Pyrykoi/Keyboard-project/README.md

Mechanical keyboard project including PCB and QMK files.
More information can be found in pdf.
