Pyrykoi/Keyboard-project/PCB v2/Pictures/explosion1.png

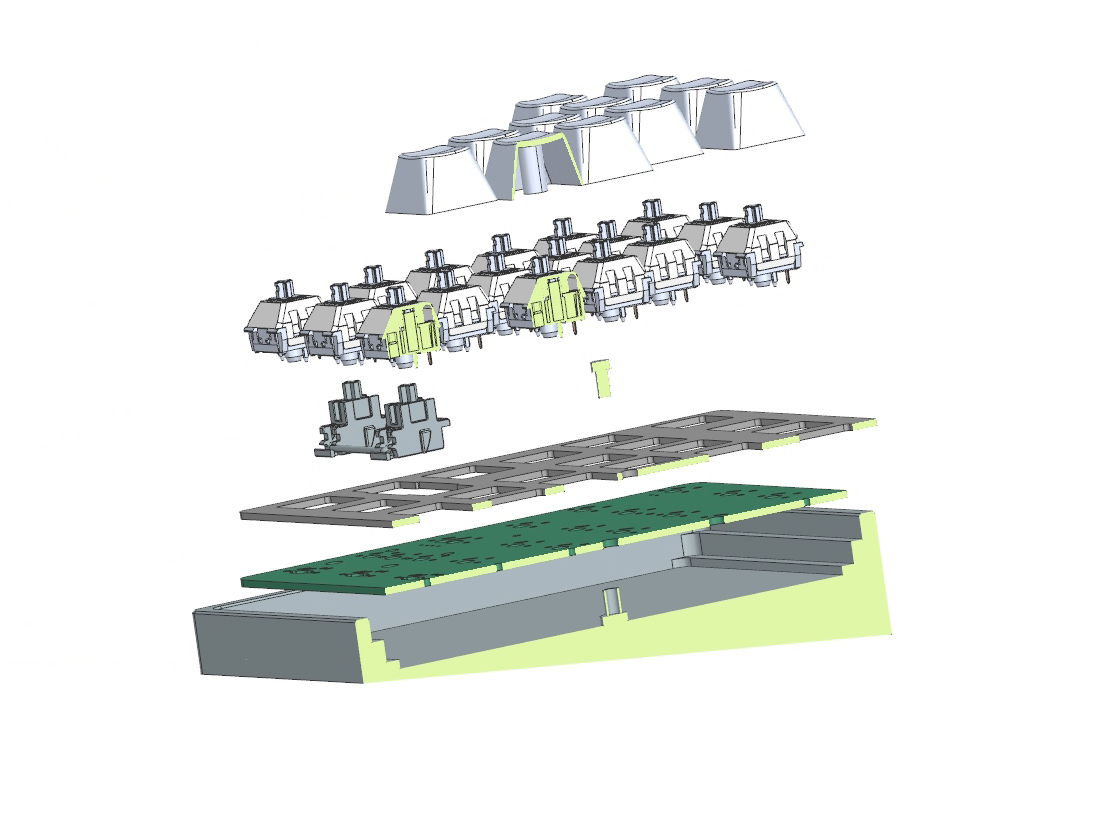
PCB v2/Pictures/explosion1.png
