Pyrykoi/Keyboard-project/PCB v2/Pictures/explosion2.png

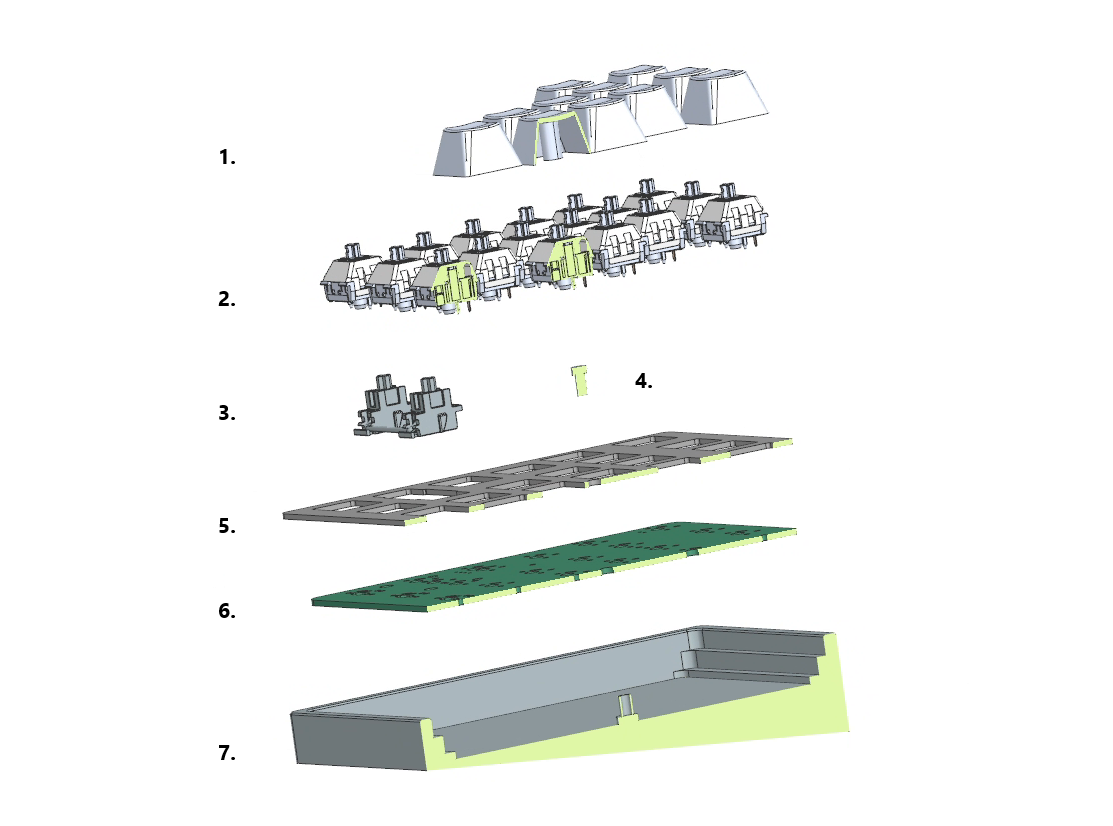
PCB v2/Pictures/explosion2.png
