Pyrykoi/Keyboard-project/PCB v2/Pictures/V2 kaikki toimii '.png

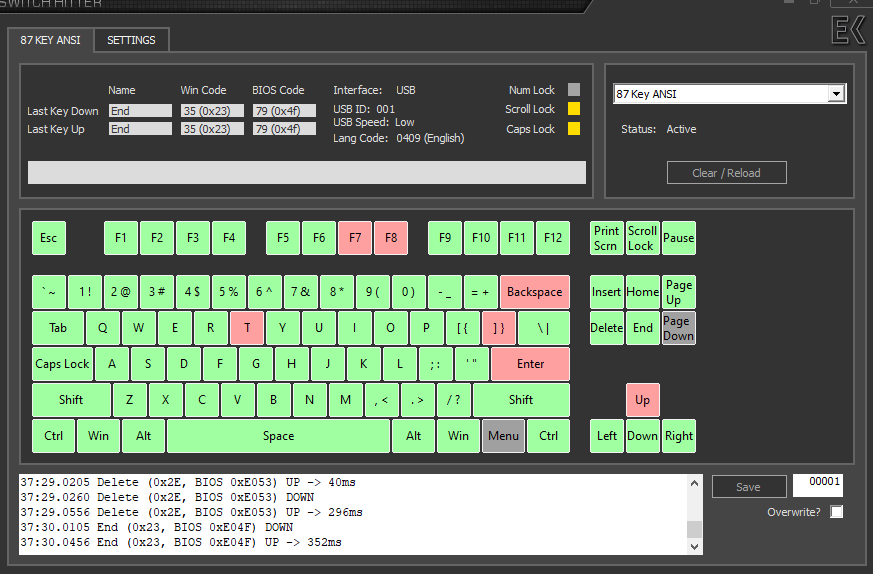
PCB v2/Pictures/V2 kaikki toimii '.png
