Pyrykoi/Keyboard-project/PCB v2/Pictures/v2 näppäimet paranneltu.png

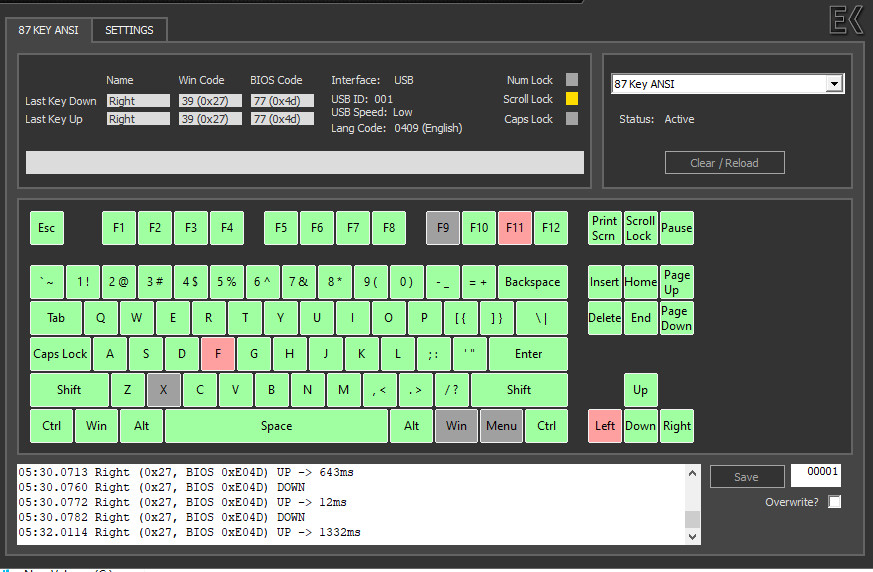
PCB v2/Pictures/v2 näppäimet paranneltu.png
