Pyrykoi/Keyboard-project/PCB v2/Pictures/v2 näppäimet.png

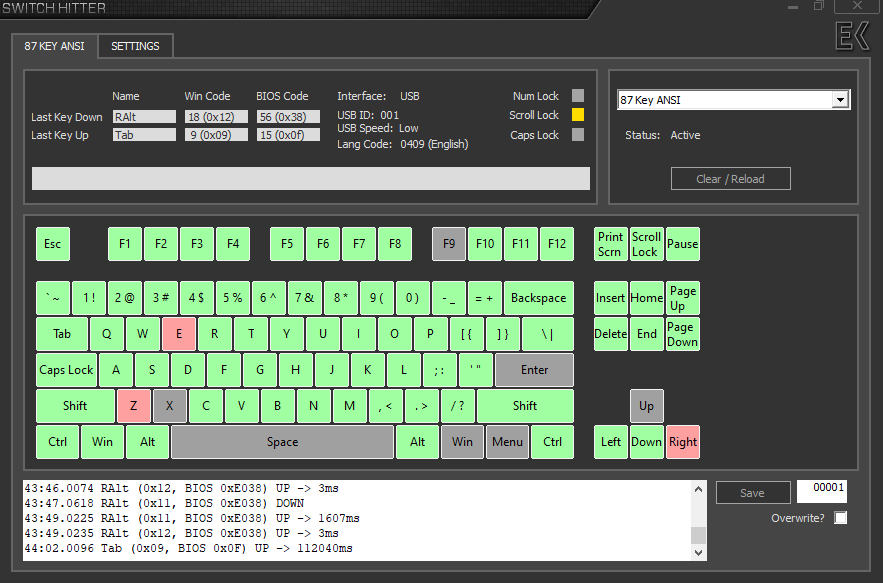
PCB v2/Pictures/v2 näppäimet.png
