Pyrykoi/Keyboard-project/Pictures/keyboard software.drawio.png

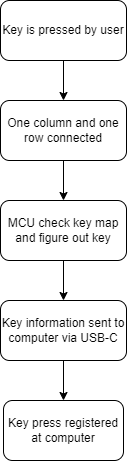
Pictures/keyboard software.drawio.png
