Pyrykoi/Keyboard-project/Pictures/keycap set.jpg

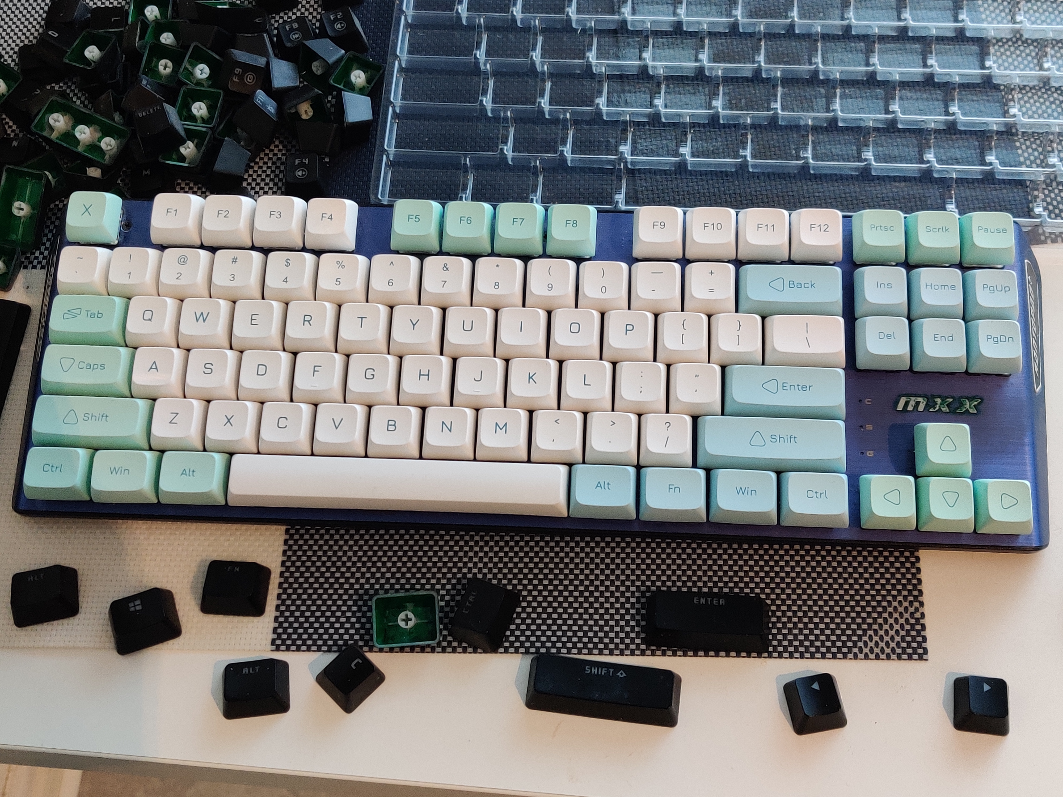
Pictures/keycap set.jpg
