Pyrykoi/Keyboard-project/Pictures/machining process.jpg

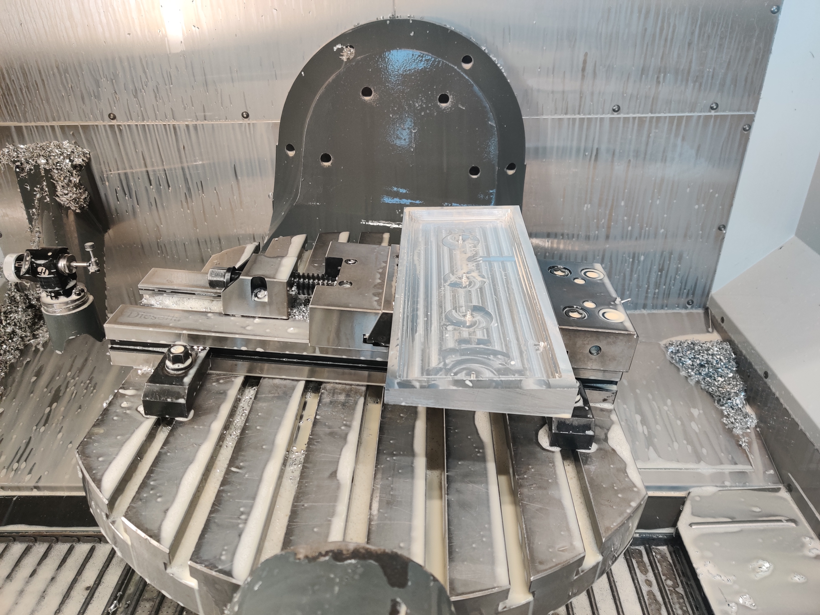
Pictures/machining process.jpg
