Pyrykoi/Keyboard-project/Pictures/ready no caps.jpg

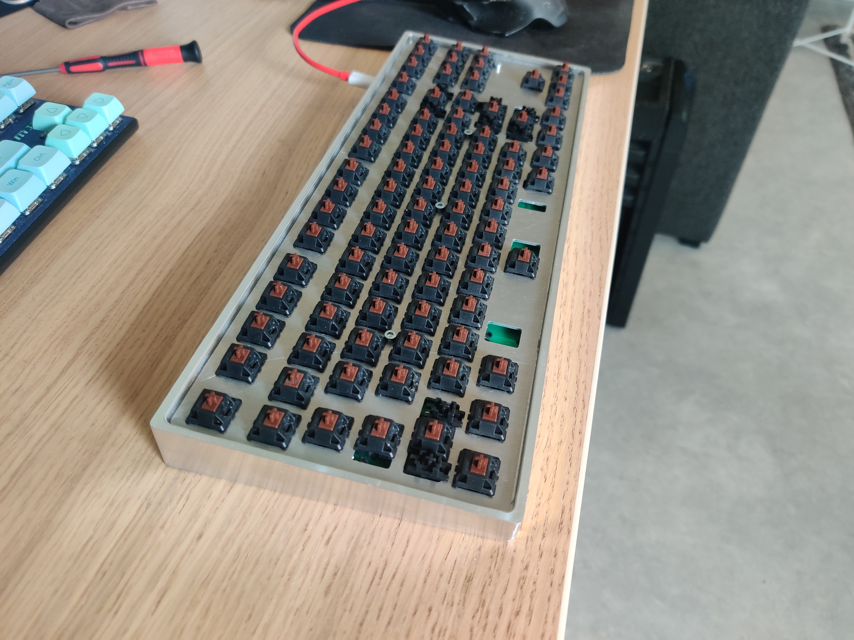
Pictures/ready no caps.jpg
