Pyrykoi/Keyboard-project/Pictures/ready.jpg

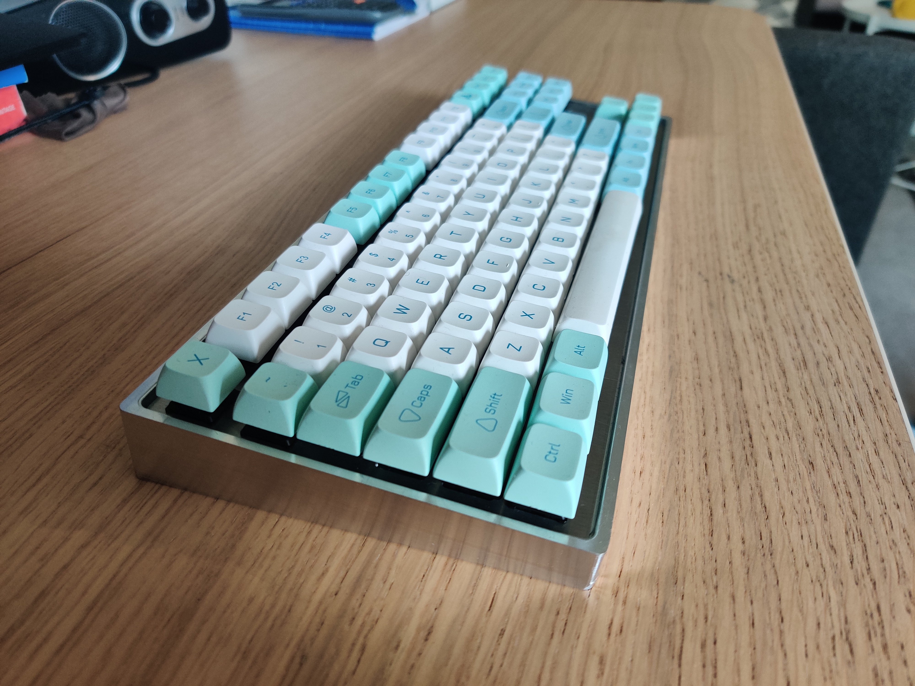
Pictures/ready.jpg
