Pyrykoi/Keyboard-project/Pictures/ruuvi.png

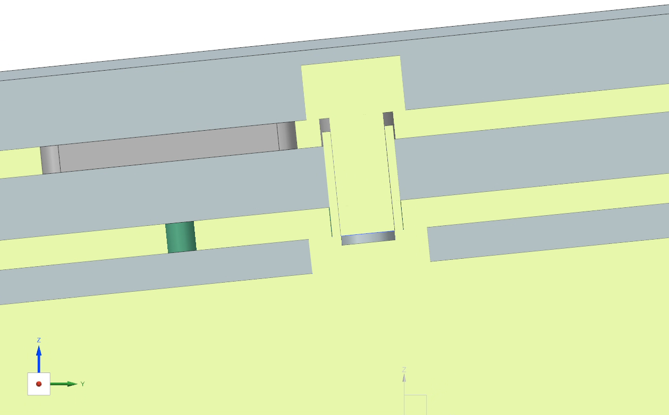
Pictures/ruuvi.png
