Pyrykoi/Keyboard-project/Pictures/varmilo.webp

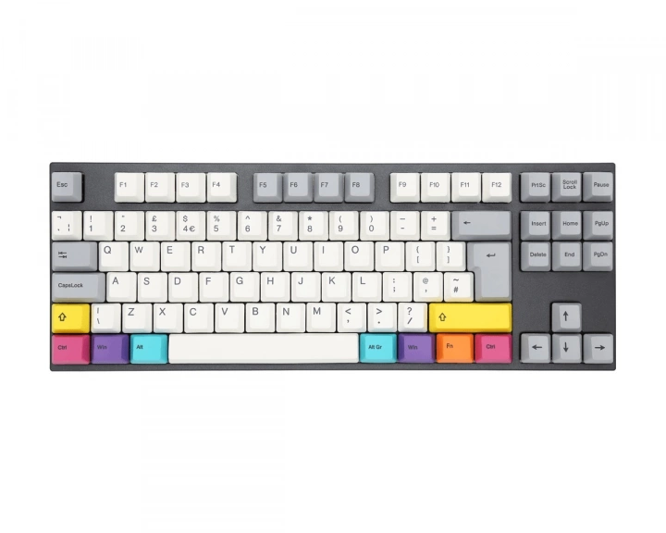
Pictures/varmilo.webp
