Pyrykoi/Keyboard-project/Documents/Budget excel.xlsx

Keyboard budget
Part | Price paid (€)
Case | 0.00 € | 254
Plate | 0.00 € | 20.85
Switches | 23.00 €
Keycaps | 21.20 €
PCB | 20.42 €
Components | 16.61 €
Cable | 6.30 €
Total: | 87.53 €
