Pyrykoi/Keyboard-project/PCB v2/UniversalTKL.kicad_sch

## KiCad design PCB v2/UniversalTKL.kicad_sch (2023-07-10)

Schematic: UniversalTKL.kicad_sch

Parts:
C_DECOUP1, C_DECOUP2, C_DECOUP3: .1u; C_0402_1005Metric_Pad0.74x0.62mm_HandSolder
C_DECOUP4: 10u; C_0402_1005Metric_Pad0.74x0.62mm_HandSolder
C_UCAP1: 1u; C_0402_1005Metric_Pad0.74x0.62mm_HandSolder
D18: PRTR5V0U2X; SOT-143
F1: Polyfuse_Small; Fuse_0805_2012Metric
J1: Reset Jumper; SW_SPST_TL3342
J2: CONN_RGB; PinHeader_1x03_P2.54mm_Vertical
J3: CONN_DB; JST_SH_SM04B-SRSS-TB_1x04-1MP_P1.00mm_Horizontal
J4: ISP_Breakout; PinHeader_2x03_P2.54mm_Vertical
R_DATA1, R_DATA2: 22; R_0805_2012Metric_Pad1.20x1.40mm_HandSolder
R_HWB1: 10k; R_0402_1005Metric_Pad0.72x0.64mm_HandSolder
R_INDICATOR1, R_INDICATOR2, R_INDICATOR3: 220; R_0402_1005Metric_Pad0.72x0.64mm_HandSolder
R_RST1: 10k; R_0402_1005Metric_Pad0.72x0.64mm_HandSolder
R_USB1, R_USB2: 5k1; R_0402_1005Metric_Pad0.72x0.64mm_HandSolder
U1: ATmega32U4-M; QFN-44-1EP_7x7mm_P0.5mm_EP5.2x5.2mm
USB1: HRO-TYPE-C-31-M-12; HRO-TYPE-C-31-M-12-Assembly
Y1: Resonator_Small; Resonator_SMD_Murata_CSTxExxV-3Pin_3.0x1.1mm

Connections:
+5V: C_DECOUP1.1, C_DECOUP2.1, C_DECOUP3.1, C_DECOUP4.1, F1.2, J2.1, J3.1, J4.2, R_RST1.1, U1.2 (UVCC), U1.7 (VBUS), U1.14 (VCC), U1.24 (AVCC), U1.34 (VCC), U1.44 (AVCC)
CAPS: R_INDICATOR1.2
D+: D18.3 (I/O2), J3.3, R_DATA1.1, USB1.6 (DP1), USB1.8 (DP2)
D-: D18.2 (I/O1), J3.2, R_DATA2.1, USB1.5 (DN2), USB1.7 (DN1)
GND: C_DECOUP1.2, C_DECOUP2.2, C_DECOUP3.2, C_DECOUP4.2, C_UCAP1.2, D18.1 (GND), J1.1, J2.3, J3.4, J4.6, R_HWB1.2, R_USB1.1, R_USB2.1, U1.5 (UGND), U1.15 (GND), U1.23 (GND), U1.35 (GND), U1.43 (GND), U1.45 (GND), USB1.1 (GND), USB1.12 (GND), Y1.2
unnamed: C_UCAP1.1, U1.6 (UCAP)
unnamed: R_DATA1.2, U1.4 (D+)
unnamed: R_DATA2.2, U1.3 (D-)
unnamed: R_HWB1.1, U1.33 (~HWB/PE2)
unnamed: R_USB1.2, USB1.10 (CC2)
unnamed: R_USB2.2, USB1.4 (CC1)
unnamed: U1.16 (XTAL2), Y1.3
unnamed: U1.17 (XTAL1), Y1.1
RST: J1.2, J4.5, R_RST1.2, U1.13 (~RESET)
VCC: D18.4 (VCC), F1.1, USB1.2 (VBUS), USB1.11 (VBUS)
col0: U1.8 (PB0)
col1: J4.3, U1.9 (PB1)
col2: J4.4, U1.10 (PB2)
col3: J4.1, U1.11 (PB3)
col4: U1.18 (PD0)
col5: U1.19 (PD1)
col6: U1.20 (PD2)
col7: U1.21 (PD3)
col8: U1.22 (PD5)
layer: R_INDICATOR3.2
lock: R_INDICATOR1.1, U1.37 (PF6)
lock2: R_INDICATOR2.1, U1.12 (PB7)
lock3: R_INDICATOR3.1, U1.1 (PE6)
rgbout: J2.2, U1.36 (PF7)
row0: U1.27 (PD7)
row1: U1.26 (PD6)
row2: U1.28 (PB4)
row3: U1.25 (PD4)
row4: U1.30 (PB6)
row5: U1.29 (PB5)
row6: U1.41 (PF0)
row7: U1.40 (PF1)
row8: U1.31 (PC6)
row9: U1.32 (PC7)
row10: U1.39 (PF4)
row11: U1.38 (PF5)
scroll: R_INDICATOR2.2
