Pyrykoi/Keyboard-project/PCB v2/matrix.kicad_sch

## KiCad design PCB v2/matrix.kicad_sch (2023-07-10)

Schematic: matrix.kicad_sch

Parts:
D1, D2, D3, D4, D5, D6, D8, D9, D10, D11, D12, D13, D14, D15, D16, D17, D19, D20, D21, D22, D23, D24, D25, D26, D27, D28, D29, D30, D31, D32, D33, D34, D35, D36, D37, D38, D39, D40, D41, D42, D43, D44, D45: BAV70_Small; SOT-23
D7, D46, D47, D48, D49, D50: D_Small; D_SOD-123
MX1: MX-LED; MX-1.25U
MX2, MX3, MX10, MX17, MX60, MX61, MX73, MX81: MX-NoLED; MX-1.25U-NoLED
MX4, MX95: MX-LED; MX-1U
MX5, MX11, MX12, MX13, MX14, MX15, MX16, MX18, MX19, MX20, MX21, MX22, MX24, MX25, MX26, MX27, MX28, MX29, MX30, MX31, MX32, MX33, MX34, MX35, MX36, MX37, MX38, MX40, MX41, MX42, MX43, MX44, MX46, MX47, MX48, MX49, MX50, MX51, MX52, MX53, MX54, MX55, MX56, MX57, MX58, MX59, MX62, MX63, MX64, MX65, MX66, MX68, MX69, MX70, MX71, MX72, MX74, MX75, MX76, MX77, MX79, MX82, MX83, MX85, MX87, MX88, MX91, MX92, MX93, MX94, MX96, MX97, MX98, MX99, MX100, MX101, MX102, MX103: MX-NoLED; MX-1U-NoLED
MX6, MX9, MX23, MX67, MX86, MX90: MX-NoLED; MX-1.5U-NoLED
MX7: MX-LED; MX-1.75U
MX8: MX-NoLED; MX-2.25U-NoLED
MX39: MX-NoLED; MX-6.25U-ReversedStabilizers-NoLED
MX45: MX-NoLED; MX-7U-ReversedStabilizers-NoLED
MX78: MX-NoLED; MX-1.75U_NoLED
MX84: MX-NoLED; MX-2.25U-ReversedStabilizers-NoLED
MX89: MX-NoLED; MX-2U-NoLED

Connections:
CAPS: MX1.3 (LED), MX7.3 (LED)
GND: MX1.4 (LEDGND), MX4.4 (LEDGND), MX7.4 (LEDGND), MX95.4 (LEDGND)
unnamed: D1.1 (A1), MX3.2 (ROW), MX9.2 (ROW)
unnamed: D1.2 (A2), MX10.2 (ROW), MX16.2 (ROW)
unnamed: D2.1 (A1), MX4.2 (ROW)
unnamed: D2.2 (A2), MX11.2 (ROW)
unnamed: D3.1 (A1), MX5.2 (ROW)
unnamed: D3.2 (A2), MX12.2 (ROW)
unnamed: D4.1 (A1), MX6.2 (ROW)
unnamed: D4.2 (A2), MX13.2 (ROW)
unnamed: D5.1 (A1), MX1.2 (ROW), MX7.2 (ROW)
unnamed: D5.2 (A2), MX14.2 (ROW)
unnamed: D6.1 (A1), MX2.2 (ROW), MX8.2 (ROW)
unnamed: D6.2 (A2), MX15.2 (ROW)
unnamed: D7.2 (A), MX22.2 (ROW)
unnamed: D8.1 (A1), MX18.2 (ROW)
unnamed: D8.2 (A2), MX24.2 (ROW)
unnamed: D9.1 (A1), MX19.2 (ROW)
unnamed: D9.2 (A2), MX25.2 (ROW)
unnamed: D10.1 (A1), MX20.2 (ROW)
unnamed: D10.2 (A2), MX26.2 (ROW)
unnamed: D11.1 (A1), MX21.2 (ROW)
unnamed: D11.2 (A2), MX27.2 (ROW)
unnamed: D12.1 (A1), MX28.2 (ROW)
unnamed: D12.2 (A2), MX33.2 (ROW)
unnamed: D13.1 (A1), MX17.2 (ROW), MX23.2 (ROW)
unnamed: D13.2 (A2), MX39.2 (ROW), MX45.2 (ROW)
unnamed: D14.1 (A1), MX29.2 (ROW)
unnamed: D14.2 (A2), MX34.2 (ROW)
unnamed: D15.1 (A1), MX30.2 (ROW)
unnamed: D15.2 (A2), MX35.2 (ROW)
unnamed: D16.1 (A1), MX31.2 (ROW)
unnamed: D16.2 (A2), MX36.2 (ROW)
unnamed: D17.1 (A1), MX32.2 (ROW)
unnamed: D17.2 (A2), MX37.2 (ROW)
unnamed: D19.1 (A1), MX38.2 (ROW)
unnamed: D19.2 (A2), MX44.2 (ROW)
unnamed: D20.1 (A1), MX40.2 (ROW)
unnamed: D20.2 (A2), MX46.2 (ROW)
unnamed: D21.1 (A1), MX41.2 (ROW)
unnamed: D21.2 (A2), MX47.2 (ROW)
unnamed: D22.1 (A1), MX42.2 (ROW)
unnamed: D22.2 (A2), MX48.2 (ROW)
unnamed: D23.1 (A1), MX43.2 (ROW)
unnamed: D23.2 (A2), MX49.2 (ROW)
unnamed: D24.1 (A1), MX50.2 (ROW)
unnamed: D24.2 (A2), MX55.2 (ROW)
unnamed: D25.1 (A1), MX52.2 (ROW)
unnamed: D25.2 (A2), MX56.2 (ROW)
unnamed: D26.1 (A1), MX53.2 (ROW)
unnamed: D26.2 (A2), MX57.2 (ROW)
unnamed: D27.1 (A1), MX54.2 (ROW)
unnamed: D27.2 (A2), MX58.2 (ROW)
unnamed: D28.1 (A1), MX51.2 (ROW)
unnamed: D28.2 (A2), MX62.2 (ROW)
unnamed: D29.1 (A1), MX60.2 (ROW)
unnamed: D29.2 (A2), MX61.2 (ROW), MX67.2 (ROW)
unnamed: D30.1 (A1), MX59.2 (ROW)
unnamed: D30.2 (A2), MX66.2 (ROW)
unnamed: D31.1 (A1), MX63.2 (ROW)
unnamed: D31.2 (A2), MX69.2 (ROW)
unnamed: D32.1 (A1), MX64.2 (ROW)
unnamed: D32.2 (A2), MX70.2 (ROW)
unnamed: D33.1 (A1), MX65.2 (ROW)
unnamed: D33.2 (A2), MX71.2 (ROW)
unnamed: D34.1 (A1), MX72.2 (ROW)
unnamed: D34.2 (A2), MX78.2 (ROW)
unnamed: D35.1 (A1), MX68.2 (ROW)
unnamed: D35.2 (A2), MX74.2 (ROW)
unnamed: D36.1 (A1), MX75.2 (ROW)
unnamed: D36.2 (A2), MX83.2 (ROW)
unnamed: D37.1 (A1), MX77.2 (ROW)
unnamed: D37.2 (A2), MX84.2 (ROW)
unnamed: D38.1 (A1), MX73.2 (ROW), MX79.2 (ROW)
unnamed: D38.2 (A2), MX81.2 (ROW), MX86.2 (ROW)
unnamed: D39.1 (A1), MX76.2 (ROW)
unnamed: D39.2 (A2), MX90.2 (ROW)
unnamed: D40.1 (A1), MX82.2 (ROW)
unnamed: D40.2 (A2), MX88.2 (ROW)
unnamed: D41.1 (A1), MX85.2 (ROW)
unnamed: D41.2 (A2), MX98.2 (ROW)
unnamed: D42.1 (A1), MX87.2 (ROW), MX89.2 (ROW)
unnamed: D42.2 (A2), MX92.2 (ROW)
unnamed: D43.1 (A1), MX91.2 (ROW)
unnamed: D43.2 (A2), MX95.2 (ROW)
unnamed: D44.1 (A1), MX93.2 (ROW)
unnamed: D44.2 (A2), MX97.2 (ROW)
unnamed: D45.1 (A1), MX94.2 (ROW)
unnamed: D45.2 (A2), MX99.2 (ROW)
unnamed: D46.2 (A), MX96.2 (ROW)
unnamed: D47.2 (A), MX100.2 (ROW)
unnamed: D48.2 (A), MX101.2 (ROW)
unnamed: D49.2 (A), MX102.2 (ROW)
unnamed: D50.2 (A), MX103.2 (ROW)
col0: MX1.1 (COL), MX2.1 (COL), MX3.1 (COL), MX4.1 (COL), MX5.1 (COL), MX6.1 (COL), MX7.1 (COL), MX8.1 (COL), MX9.1 (COL), MX17.1 (COL), MX18.1 (COL), MX19.1 (COL), MX20.1 (COL), MX21.1 (COL), MX22.1 (COL), MX23.1 (COL)
col1: MX10.1 (COL), MX11.1 (COL), MX12.1 (COL), MX13.1 (COL), MX14.1 (COL), MX15.1 (COL), MX16.1 (COL), MX24.1 (COL), MX25.1 (COL), MX26.1 (COL), MX27.1 (COL), MX28.1 (COL)
col2: MX29.1 (COL), MX30.1 (COL), MX31.1 (COL), MX32.1 (COL), MX33.1 (COL), MX39.1 (COL), MX40.1 (COL), MX41.1 (COL), MX42.1 (COL), MX43.1 (COL), MX44.1 (COL), MX45.1 (COL)
col3: MX34.1 (COL), MX35.1 (COL), MX36.1 (COL), MX37.1 (COL), MX38.1 (COL), MX46.1 (COL), MX47.1 (COL), MX48.1 (COL), MX49.1 (COL), MX50.1 (COL)
col4: MX51.1 (COL), MX52.1 (COL), MX53.1 (COL), MX54.1 (COL), MX55.1 (COL), MX61.1 (COL), MX62.1 (COL), MX63.1 (COL), MX64.1 (COL), MX65.1 (COL), MX66.1 (COL), MX67.1 (COL)
col5: MX56.1 (COL), MX57.1 (COL), MX58.1 (COL), MX59.1 (COL), MX60.1 (COL), MX68.1 (COL), MX69.1 (COL), MX70.1 (COL), MX71.1 (COL), MX72.1 (COL)
col6: MX73.1 (COL), MX74.1 (COL), MX75.1 (COL), MX76.1 (COL), MX77.1 (COL), MX78.1 (COL), MX79.1 (COL), MX87.1 (COL), MX88.1 (COL), MX89.1 (COL), MX90.1 (COL)
col7: MX81.1 (COL), MX82.1 (COL), MX83.1 (COL), MX84.1 (COL), MX85.1 (COL), MX86.1 (COL), MX91.1 (COL), MX92.1 (COL), MX93.1 (COL), MX94.1 (COL)
col8: MX95.1 (COL), MX96.1 (COL), MX97.1 (COL), MX98.1 (COL), MX99.1 (COL), MX100.1 (COL), MX101.1 (COL), MX102.1 (COL), MX103.1 (COL)
layer: MX4.3 (LED)
row0: D2.3 (K), D14.3 (K), D28.3 (K), D40.3 (K), D47.1 (K)
row1: D8.3 (K), D20.3 (K), D35.3 (K), D43.3 (K)
row2: D3.3 (K), D15.3 (K), D25.3 (K), D36.3 (K), D46.1 (K)
row3: D9.3 (K), D21.3 (K), D31.3 (K), D42.3 (K), D48.1 (K)
row4: D4.3 (K), D16.3 (K), D26.3 (K), D39.3 (K), D49.1 (K)
row5: D10.3 (K), D22.3 (K), D32.3 (K), D44.3 (K)
row6: D5.3 (K), D17.3 (K), D27.3 (K), D37.3 (K)
row7: D11.3 (K), D23.3 (K), D33.3 (K)
row8: D6.3 (K), D12.3 (K), D24.3 (K), D34.3 (K)
row9: D7.1 (K), D19.3 (K), D30.3 (K), D41.3 (K)
row10: D1.3 (K), D29.3 (K), D45.3 (K)
row11: D13.3 (K), D38.3 (K), D50.1 (K)
scroll: MX95.3 (LED)
