Pyrykoi/Keyboard-project/h88/config.h

/*
Copyright 2019 Josh Hinnebusch

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
You should have received a copy of the GNU General Public License
along with this program.  If not, see <http://www.gnu.org/licenses/>.
*/

#pragma once

#include "config_common.h"

/* key matrix size */
#define MATRIX_ROWS 12
#define MATRIX_COLS 9

/*
 * Keyboard Matrix Assignments
 *
 * Change this to how you wired your keyboard
 * COLS: AVR pins used for columns, left to right
 * ROWS: AVR pins used for rows, top to bottom
 * DIODE_DIRECTION: COL2ROW = COL = Anode (+), ROW = Cathode (-, marked on diode)
 *                  ROW2COL = ROW = Anode (+), COL = Cathode (-, marked on diode)
 *
*/
#define MATRIX_ROW_PINS { D7, D6, B4, D4, B6, B5, F0, F1, C6, C7, F4, F5 }
#define MATRIX_COL_PINS { B0, B1, B2, B3, D0, D1, D2, D3, D5 }

/* COL2ROW, ROW2COL*/
#define DIODE_DIRECTION COL2ROW

#define BACKLIGHT_PIN E6
// #define BACKLIGHT_BREATHING
#define BACKLIGHT_LEVELS 3

/* Debounce reduces chatter (unintended double-presses) - set 0 if debouncing is not needed */
#define DEBOUNCE 5

/* define if matrix has ghost (lacks anti-ghosting diodes) */
//#define MATRIX_HAS_GHOST

/* number of backlight levels */

/* Mechanical locking support. Use KC_LCAP, KC_LNUM or KC_LSCR instead in keymap */
#define LOCKING_SUPPORT_ENABLE
/* Locking resynchronize hack */
#define LOCKING_RESYNC_ENABLE

#define RGB_DI_PIN 0
#ifdef RGB_DI_PIN
#define RGBLIGHT_EFFECT_BREATHING
#define RGBLIGHT_EFFECT_RAINBOW_MOOD
#define RGBLIGHT_EFFECT_RAINBOW_SWIRL
#define RGBLIGHT_EFFECT_SNAKE
#define RGBLIGHT_EFFECT_KNIGHT
#define RGBLIGHT_EFFECT_CHRISTMAS
#define RGBLIGHT_EFFECT_STATIC_GRADIENT
#define RGBLIGHT_EFFECT_RGB_TEST
#define RGBLIGHT_EFFECT_ALTERNATING
#define RGBLIGHT_EFFECT_TWINKLE
#define RGBLED_NUM 24
#define RGBLIGHT_HUE_STEP 8
#define RGBLIGHT_SAT_STEP 8
#define RGBLIGHT_VAL_STEP 8
#define RGBLIGHT_SLEEP // RGB will turn off when PC is put to sleep
#endif
