Pyrykoi/Keyboard-project/(commit log)

2023-07-10 importing files
    [UniversalTKL-B_Cu.gbl, UniversalTKL-B_Mask.gbs, UniversalTKL-B_Paste.gbp, UniversalTKL-B_Silkscreen.gbo, UniversalTKL-Edge_Cuts.gm1, UniversalTKL-F_Cu.gtl, UniversalTKL-F_Mask.gts, UniversalTKL-F_Paste.gtp]
2023-07-10 Changed order of stuff
    [UniversalTKL-B_Cu.gbl, UniversalTKL-B_Mask.gbs, UniversalTKL-B_Paste.gbp, UniversalTKL-B_Silkscreen.gbo, UniversalTKL-Edge_Cuts.gm1, UniversalTKL-F_Cu.gtl, UniversalTKL-F_Mask.gts, UniversalTKL-F_Paste.gtp]
2023-07-13 Moved to correct report layout
    [Budget excel.xlsx]
2024-02-14 Siivous ja viimeistely
    [Budget excel.xlsx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]
