Pyrykoi/Keyboard-project/Pictures/plate testing.jpg

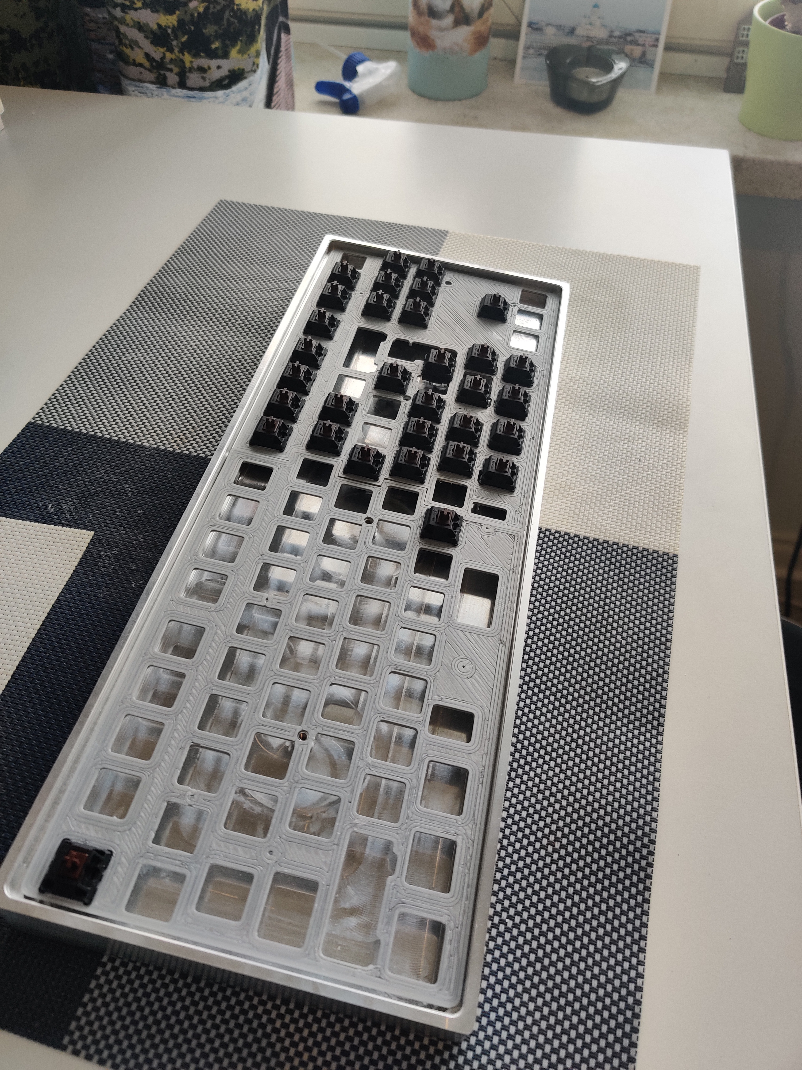
Pictures/plate testing.jpg
