Pyrykoi/Keyboard-project/Pictures/MCU.jpg

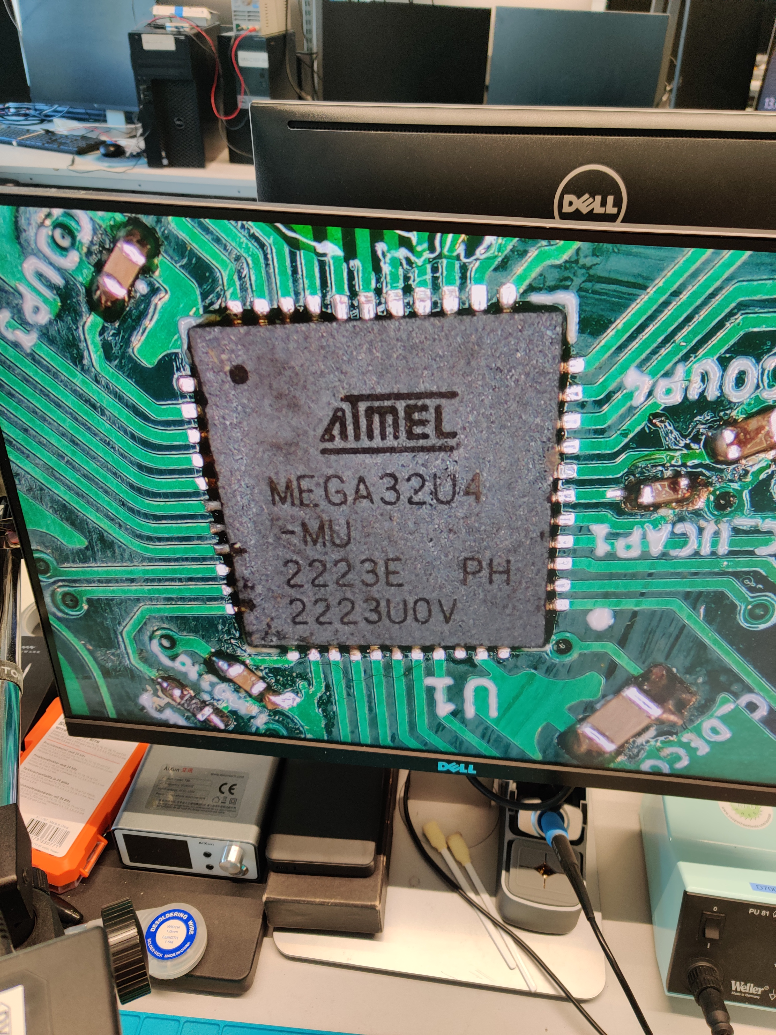
Pictures/MCU.jpg
